EPIPsunny/Inverted-Pendulum/倒立摆代码3.0/单机片参考代码/RDS3120.jpg

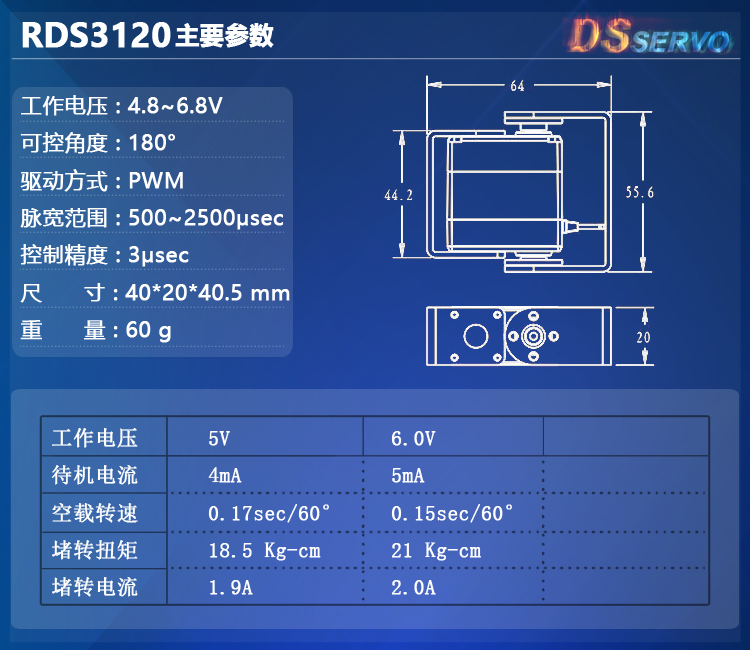
倒立摆代码3.0/单机片参考代码/RDS3120.jpg
