EPIPsunny/Inverted-Pendulum/README.md

# Inverted-Pendulum
倒立摆
包含原理图PCB（底板，stm32f103c8t6，tb6612），C8T6代码，操作手册，制作报告
