EPIPsunny/Inverted-Pendulum/倒立摆代码3.0/README.TXT

更改SOLGUI_Hardware.c
       SOLGUI_Config.h文件
OLED_FillScreen(GRAM);把一个页面的信息打印到界面上==OLED_ShowPicture。
GRAM记录了一个页面的信息。
