EPIPsunny/Inverted-Pendulum/tb6612/6612/Project Outputs for 6612/boom表.xlsx

Comment | Description | Designator | Footprint | LibRef | Quantity
10μF | 贴片电容/MLCC电容 | C1, C3 | C0805_L | C | 2
0.1μF | 贴片电容/MLCC电容 | C2, C4 | C0805_L | C | 2
HDR-1X8 | 8P接插件 | JP1, JP2 | HDR2.54-LI-8P | Header 8 | 2
TB6612FNG | 电机驱动 | U0 | SSOP24_M | TB6612FNG | 1
