EPIPsunny/Inverted-Pendulum/c8t6原理图封装库/stm32f103c8t6/Sheet1.pdf

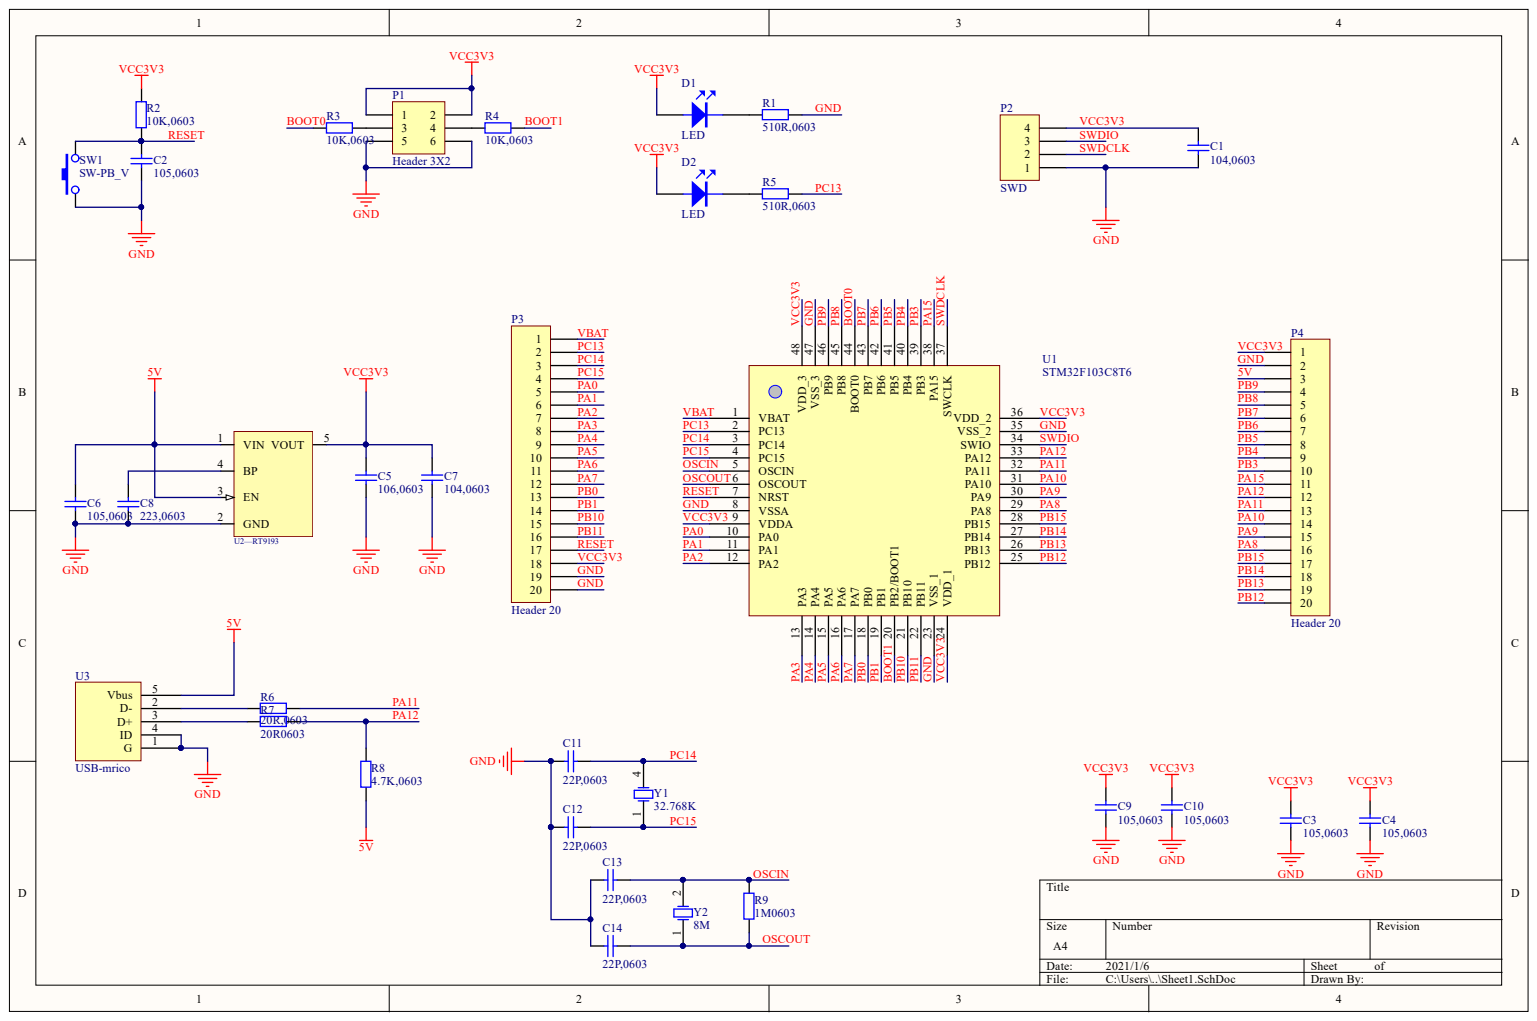
[picture p10: page 1]
