EPIPsunny/Inverted-Pendulum/倒立摆电路板/PCB_Project/倒立摆原理图.pdf

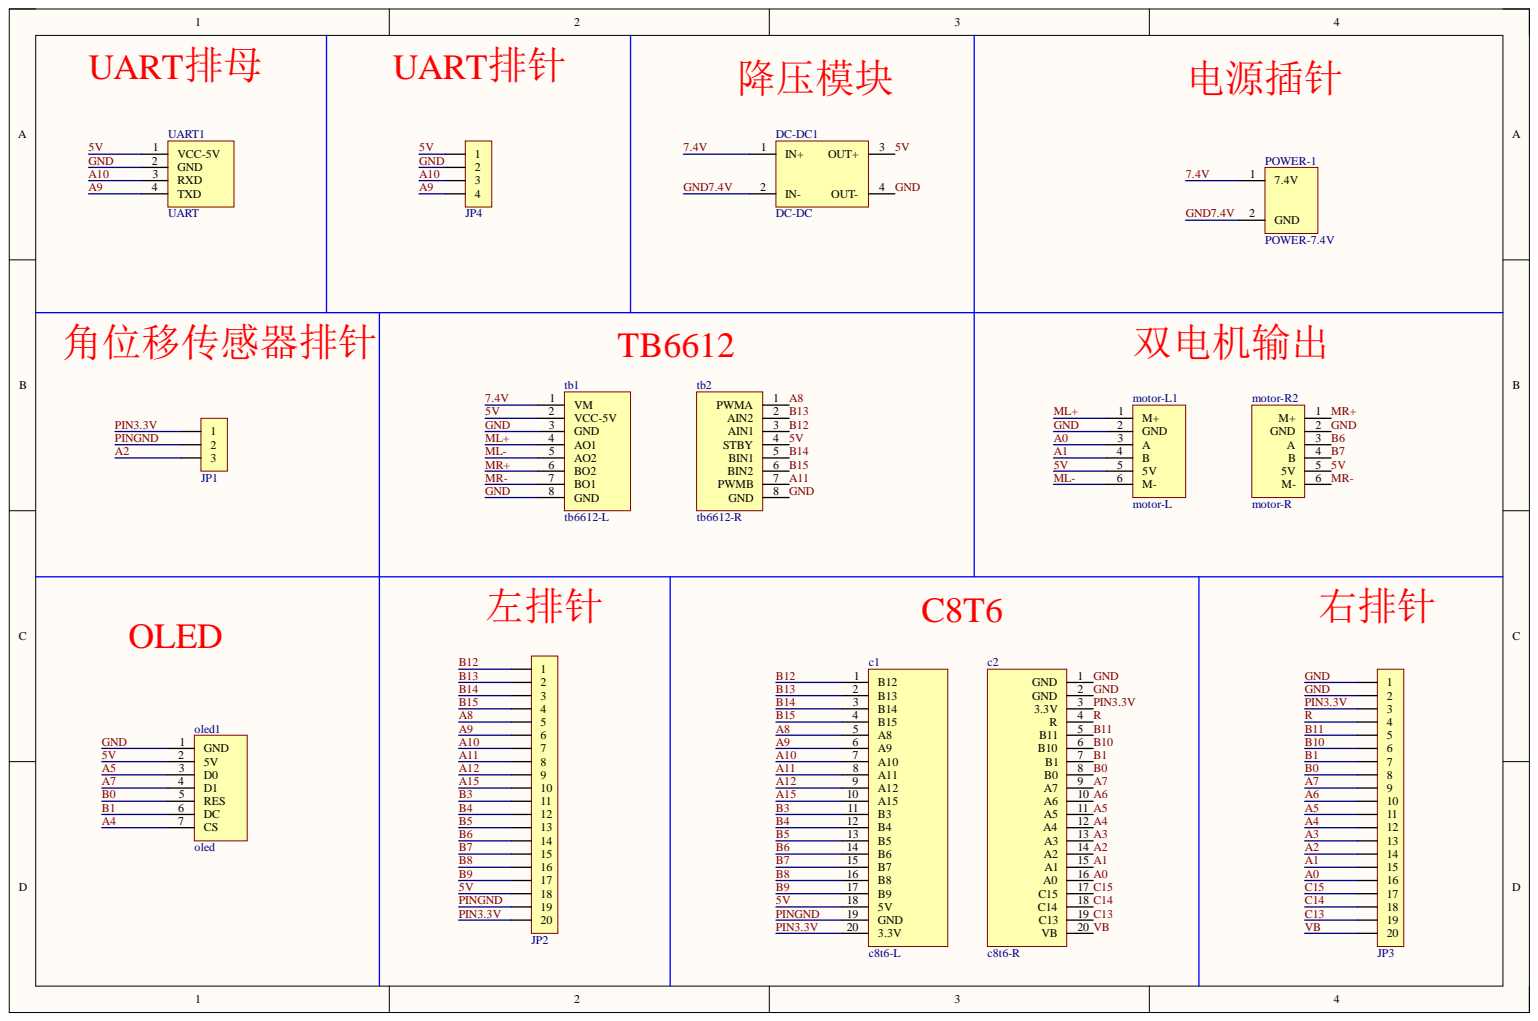
[picture p11: page 1]
