EPIPsunny/Inverted-Pendulum/(list of files, drawings)

Other design files:
c8t6原理图封装库/stm32f103c8t6/Sheet1.SchDoc
c8t6原理图封装库/stm32f103c8t6/STM32F103C8T6核心板.PcbDoc
c8t6原理图封装库/stm32f103c8t6/STM32F103C8T6核心板.PcbLib
tb6612/6612/6612.PcbDoc
tb6612/6612/6612.PrjPcb
tb6612/6612/6612.SchDoc
倒立摆电路板/PCB_Project/PCB_Project.PrjPcb
倒立摆电路板/PCB_Project/倒立摆pcb.PcbDoc
倒立摆电路板/PCB_Project/倒立摆原理图.SchDoc
