EPIPsunny/Inverted-Pendulum/倒立摆代码3.0/MKFILE/zimo.h

#ifndef __zimo_H
#define __zimo_H
/////////////////////////////const常量只能被一个文件引用/////////////////////////////////////


//////////////////////////////////////报错的图片///////////////////////////////////
const unsigned char zimo1[]= { /* 0X12,0X01,0X00,0X40,0X00,0X39, */   
0X00,0X00,0X00,0X00,0X00,0X00,0X00,0X00,0X00,0X00,0X00,0X00,0X00,0X00,0X00,0X00,
0X00,0X00,0X00,0X00,0X00,0X01,0X01,0X03,0X03,0X03,0X03,0X07,0X07,0X07,0X07,0X07,
0X07,0X07,0X07,0X07,0X03,0X03,0X03,0X03,0X01,0X01,0X00,0X00,0X00,0X00,0X00,0X00,
0X00,0X00,0X00,0X00,0X00,0X00,0X00,0X00,0X00,0X00,0X00,0X00,0X00,0X00,0X00,0X00,
0X00,0X00,0X00,0X00,0X00,0X00,0X00,0X00,0X00,0X00,0X00,0X00,0X03,0X07,0X0F,0X1F,
0X3F,0X7E,0X7E,0XFC,0XF8,0XF0,0XF0,0XE0,0XE0,0XE0,0XC0,0XC0,0XC0,0XC0,0XC0,0XC0,
0XC0,0XC0,0XC0,0XC0,0XC0,0XE0,0XE0,0XE0,0XF0,0XF1,0XF9,0XFB,0X7B,0X37,0X37,0X0F,
0X0F,0X0E,0X1D,0X08,0X00,0X00,0X00,0X00,0X00,0X00,0X00,0X00,0X00,0X00,0X00,0X00,
0X00,0X00,0X00,0X00,0X00,0X00,0X00,0X00,0X03,0X1F,0X7F,0XFF,0XFF,0XFC,0XF0,0XC0,
0X80,0X00,0X10,0X38,0X3C,0X3E,0X3F,0X1F,0X1F,0X0F,0X0F,0X07,0X03,0X01,0X01,0X01,
0X03,0X07,0X0F,0X0F,0X1F,0X3F,0X7F,0X7E,0XFC,0XF8,0XF0,0XE0,0XE0,0XC0,0X80,0X40,
0XF0,0XFC,0XFF,0XFF,0X7F,0X1F,0X03,0X00,0X00,0X00,0X00,0X00,0X00,0X00,0X00,0X00,
0X00,0X00,0X00,0X00,0X00,0X00,0X00,0X08,0XFF,0XFF,0XFF,0XFF,0X80,0X00,0X00,0X00,
0X00,0X00,0X00,0X00,0X00,0X00,0X00,0X81,0XC3,0XC7,0XEF,0XFF,0XFF,0XFF,0XFF,0XFF,
0XFF,0XFF,0XFF,0XEF,0XC7,0X83,0X01,0X00,0X00,0X00,0X00,0X00,0X00,0X00,0X00,0X00,
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
0X00,0X00,0X00,0X00,0X00,0X00,0X00,0X00,0X00,0X80,0XE0,0XF0,0XF0,0XF0,0XF0,0XF0,
0XF0,0XF0,0XF0,0XF0,0XE0,0X80,0X00,0X00,0X00,0X00,0X00,0X00,0X00,0X00,0X00,0X00,
}
};

//////////////////////////////////////////////////////////////////////////////////


#endif
