EPIPsunny/Inverted-Pendulum/倒立摆代码3.0/MKFILE/LED/led.c

#include "led.h"

//////////////////////////////////////////////////////////////////////////////////	 
//本程序只供学习使用，未经作者许可，不得用于其它任何用途
//ALIENTEK 精英STM32开发板
//LED驱动代码	   
//正点原子@ALIENTEK
//技术论坛:www.openedv.com
//修改日期:2012/9/2
//版本：V1.0
//版权所有，盗版必究。
//Copyright(C) 广州市星翼电子科技有限公司 2009-2019
//All rights reserved									  
////////////////////////////////////////////////////////////////////////////////// 	   

//初始化PB5和PE5为输出口.并使能这两个口的时钟		    
//LED IO初始化
void LED_Init(void)
{
 
 GPIO_InitTypeDef GPIO_InitStructure;
  RCC_APB2PeriphClockCmd( RCC_APB2Periph_GPIOC, ENABLE); // 使能PC端口时钟  
  GPIO_InitStructure.GPIO_Pin = GPIO_Pin_13;	//选择对应的引脚
  GPIO_InitStructure.GPIO_Mode = GPIO_Mode_Out_PP;       
  GPIO_InitStructure.GPIO_Speed = GPIO_Speed_50MHz;
  GPIO_Init(GPIOC, &GPIO_InitStructure);  //初始化PC端口
  GPIO_SetBits(GPIOC, GPIO_Pin_13 );
}
 
