EPIPsunny/Inverted-Pendulum/倒立摆代码3.0/MKFILE/OLED/oled.h

#ifndef __OLED_H
#define __OLED_H			  	 
#include "sys.h"
#include "stdlib.h"	    	
//OLED模式设置
//0:4线串行模式
//1:并行8080模式
#define OLED_MODE 0
#define SIZE 12
#define XLevelL		0x00
#define XLevelH		0x10
#define Max_Column	128
#define Max_Row		64
#define	Brightness	0xFF 
#define X_WIDTH 	128
#define Y_WIDTH 	64	    
#define OLED_Y_PAGE				8		//Y方向页长度



//-----------------OLED端口定义----------------  					   

#define OLED_SCLK_Clr() GPIO_ResetBits(GPIOA,GPIO_Pin_5)//CLK
#define OLED_SCLK_Set() GPIO_SetBits(GPIOA,GPIO_Pin_5)

#define OLED_SDIN_Clr() GPIO_ResetBits(GPIOA,GPIO_Pin_7)//DIN
#define OLED_SDIN_Set() GPIO_SetBits(GPIOA,GPIO_Pin_7)

#define OLED_RST_Clr() GPIO_ResetBits(GPIOB,GPIO_Pin_0)//RES
#define OLED_RST_Set() GPIO_SetBits(GPIOB,GPIO_Pin_0)

#define OLED_DC_Clr() GPIO_ResetBits(GPIOB,GPIO_Pin_1)//DC
#define OLED_DC_Set() GPIO_SetBits(GPIOB,GPIO_Pin_1)

#define OLED_CS_Clr()  GPIO_ResetBits(GPIOA,GPIO_Pin_4)//CS
#define OLED_CS_Set()  GPIO_SetBits(GPIOA,GPIO_Pin_4)



#define OLED_CMD  0	//写命令
#define OLED_DATA 1	//写数据


//OLED控制用函数
void OLED_WR_Byte(u8 dat,u8 cmd);	    
void OLED_Display_On(void);
void OLED_Display_Off(void);	   							   		    
void OLED_Init(void);																		//OLED初始化
void OLED_Clear(void);																	//清屏
void OLED_DrawPoint(u8 x,u8 y,u8 t);
void OLED_Fill(u8 x1,u8 y1,u8 x2,u8 y2,u8 dot);
void OLED_ShowChar(u8 x,u8 y,u8 chr);										
void OLED_ShowNum(u8 x,u8 y,u32 num,u8 len,u8 size);
void OLED_ShowString(u8 x,u8 y, u8 *p);	 
void OLED_Set_Pos(unsigned char x, unsigned char y);
void OLED_ShowCHinese(u8 x,u8 y,u8 no);
void OLED_DrawBMP(unsigned char x0, unsigned char y0,unsigned char x1, unsigned char y1,unsigned char BMP[]);
void OLED_FillScreen(u8 gram[X_WIDTH][OLED_Y_PAGE]);		//整屏刷新（显存数组指针）

#endif  
	 
