EPIPsunny/Inverted-Pendulum/倒立摆代码3.0/MKFILE/WIFI/wifi.h

#ifndef __WIFI_H
#define __WIFI_H	 
#include "stdio.h"	
#include "sys.h" 
#include "led.h"
#define USART1_REC_LEN  			200  	//定义最大接收字节数 200
#define USART1_SEND_LEN       200
#define EN_USART1_RX 			1		//使能（1）/禁止（0）串口1接收
	  	
extern u8  USART_RX_BUF1[USART1_REC_LEN]; //接收缓冲,最大USART_REC_LEN个字节.末字节为换行符 
extern u16 USART_RX_STA1;         		//接收状态标记	


//如果想串口中断接收，请不要注释以下宏定义
void uart1_init(u32 bound);
void WIFI_GIVE_CMD(char *cmd);
void u1_printf(char* fmt,...);


#endif
