EPIPsunny/Inverted-Pendulum/(notices)

Notices in the files:
倒立摆代码3.0/MKFILE/MPU6050/mpu6050.c:
Copyright(C) ¹ãÖÝÊÐÐÇÒíµç×Ó¿Æ¼¼ÓÐÏÞ¹«Ë¾ 2009-2019
All rights reserved
